NotSoNinja/Looma-Motherboard-R2/README.md

Looma-Motherboard-R2
====================

Revision 2+ of Looma's Motherboard
