NotSoNinja/Looma-Motherboard-R2/MotherBoard Design Review Presentation.pptx

## Looma 2 Motherboard Design Review

## Motherboard Components

Previous Design:
- 5V Buck Circuit
- Audio Amplifier
- USB Hub
- Ethernet
Re-designed:
- Surge Stopper
- 19.5V Boost Circuit
- Added Fan Control

## Slide 3

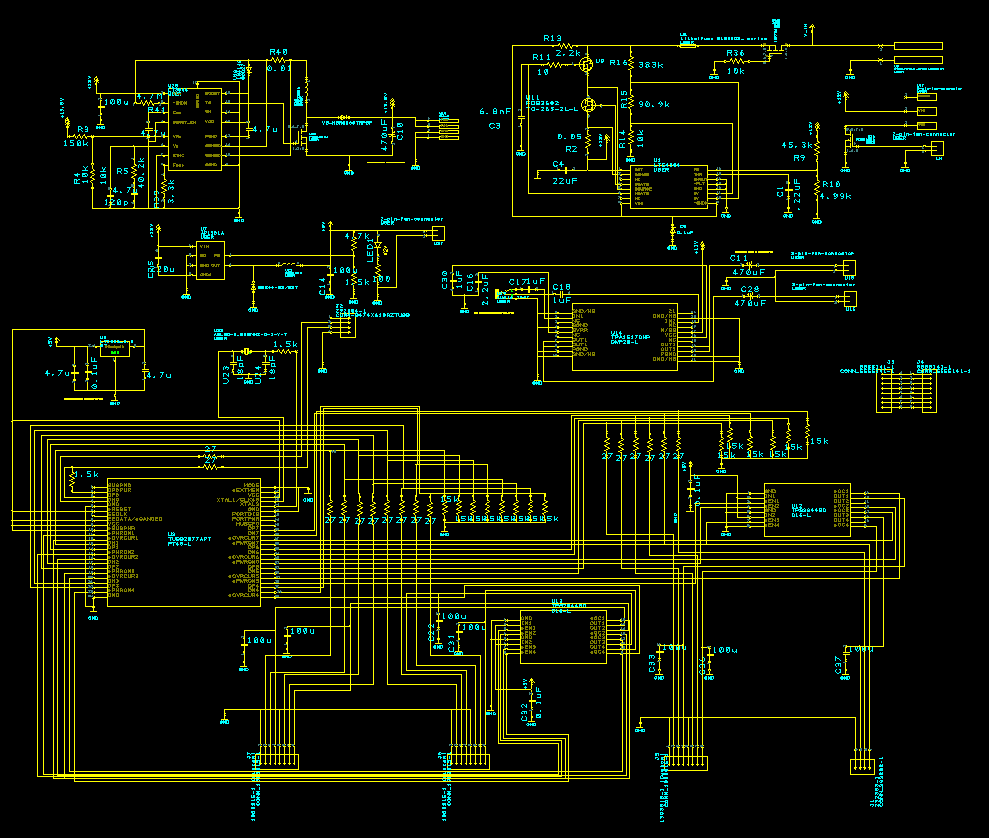
[picture p1: figure]

## Surge Protector

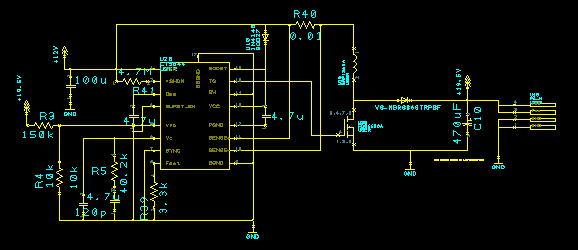
[picture p2: figure]

## Boost Circuit Protector

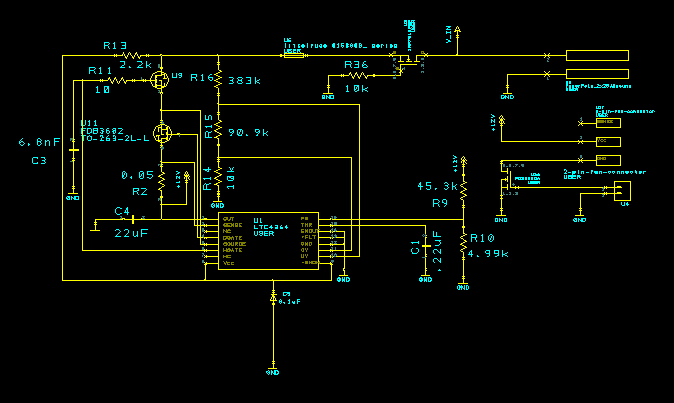
[picture p3: figure]

## Slide 6

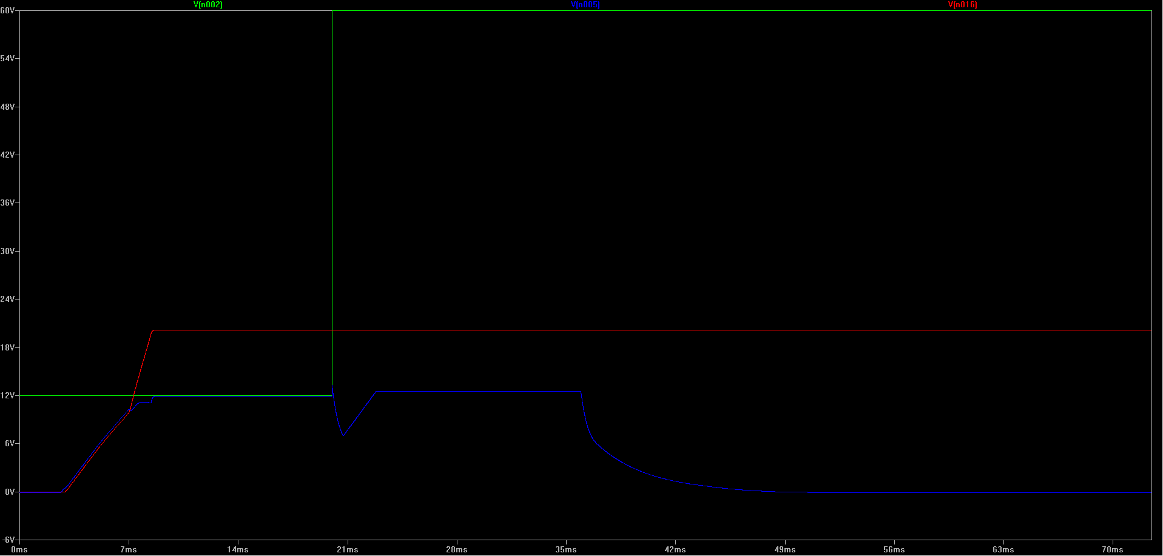
[picture p4: figure]

Boost Circuit + Surge Protector without Load

Boost Circuit Output = 19.68 V

Surge Protector Output = Boost Circuit Input

Surge Protector Input

Notes: No load

## Slide 7

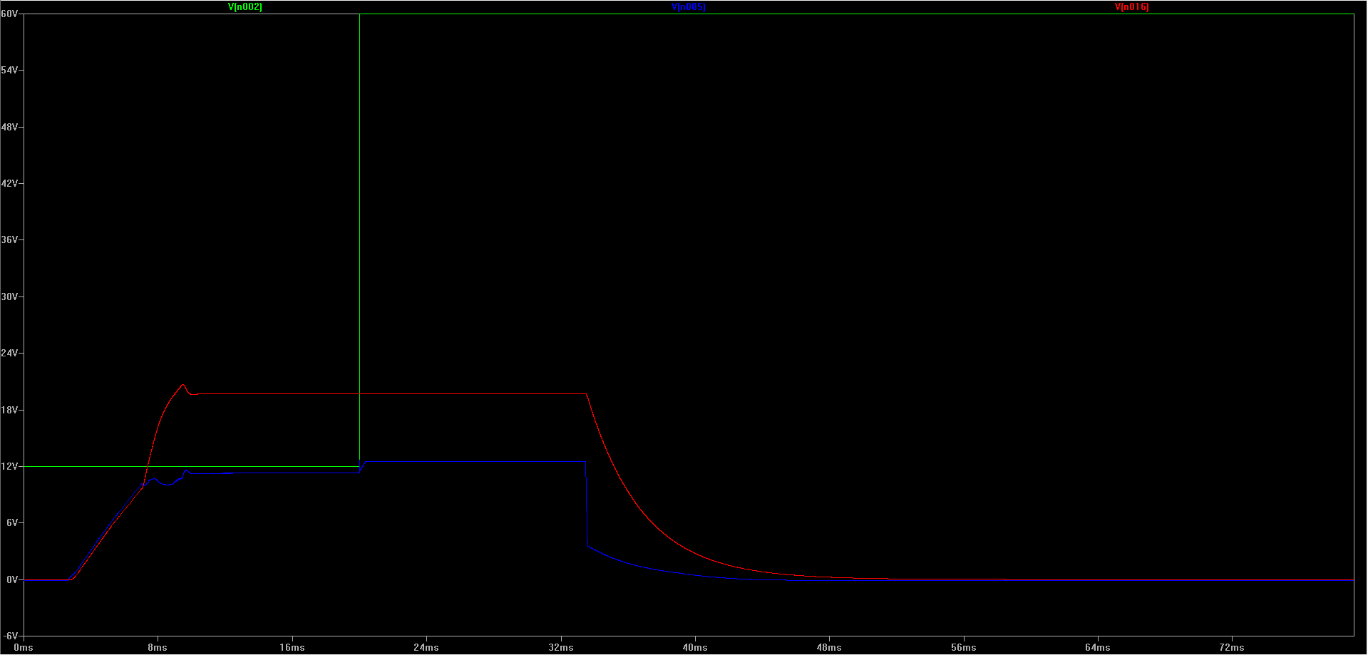
[picture p5: figure]

Boost Circuit + Surge Protector with Load

Surge Protector Output = Boost Circuit Input

Surge Protector Input

Boost Circuit Output = 19.68 V

Notes: Load

## Slide 8

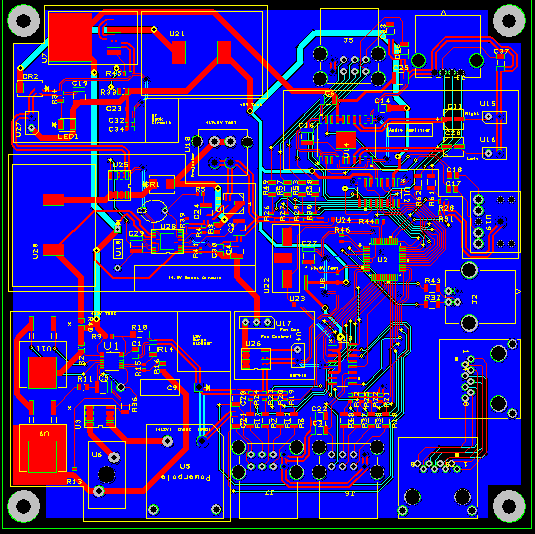
[picture p6: figure]
