NotSoNinja/Looma-Motherboard-R2/Looma 2 Components Flow Chart.jpeg

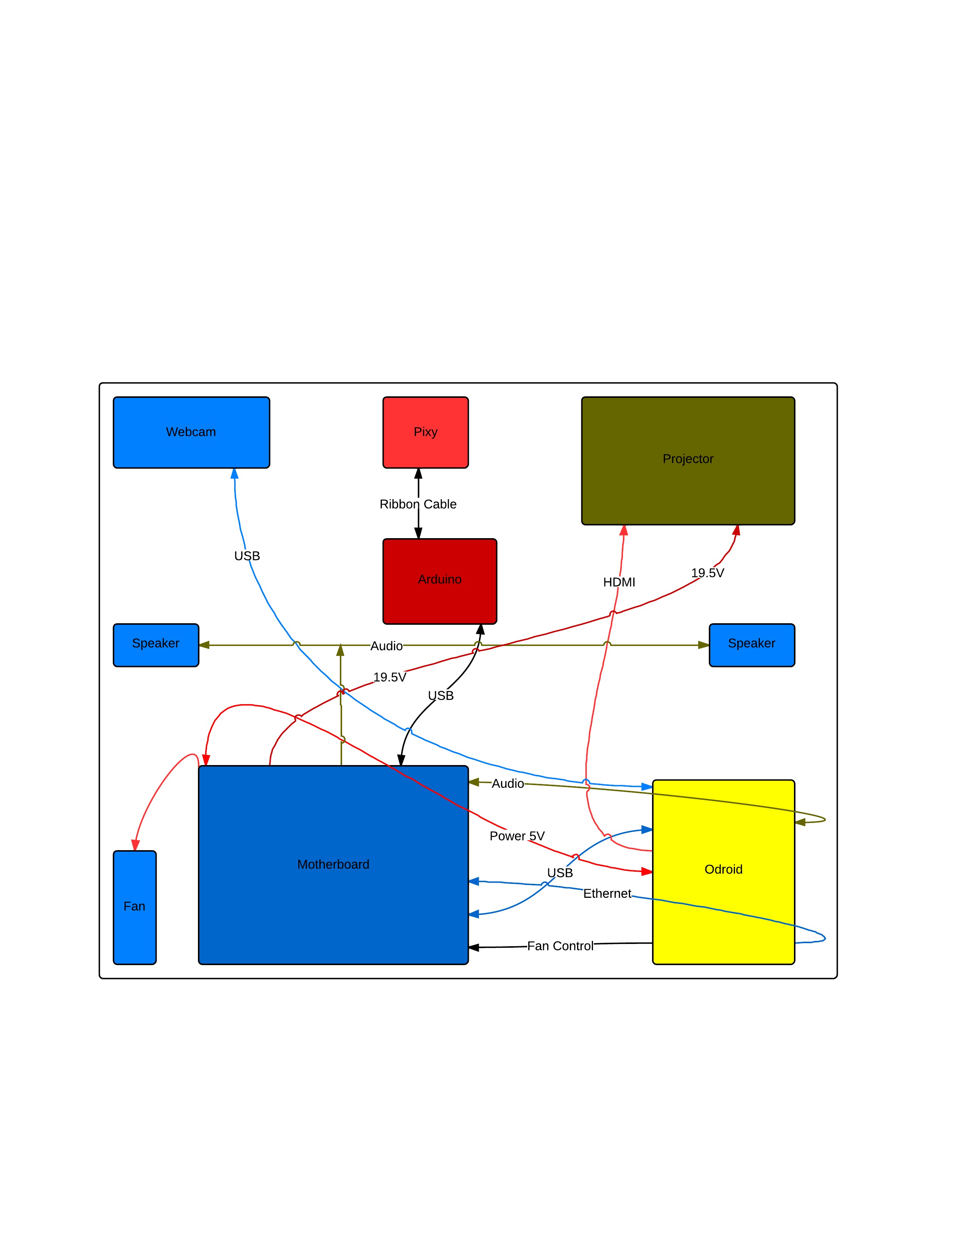
Looma 2 Components Flow Chart.jpeg
