NotSoNinja/Looma-Motherboard-R2/Mother Board R2.4 - Schematic - Schematic.pdf

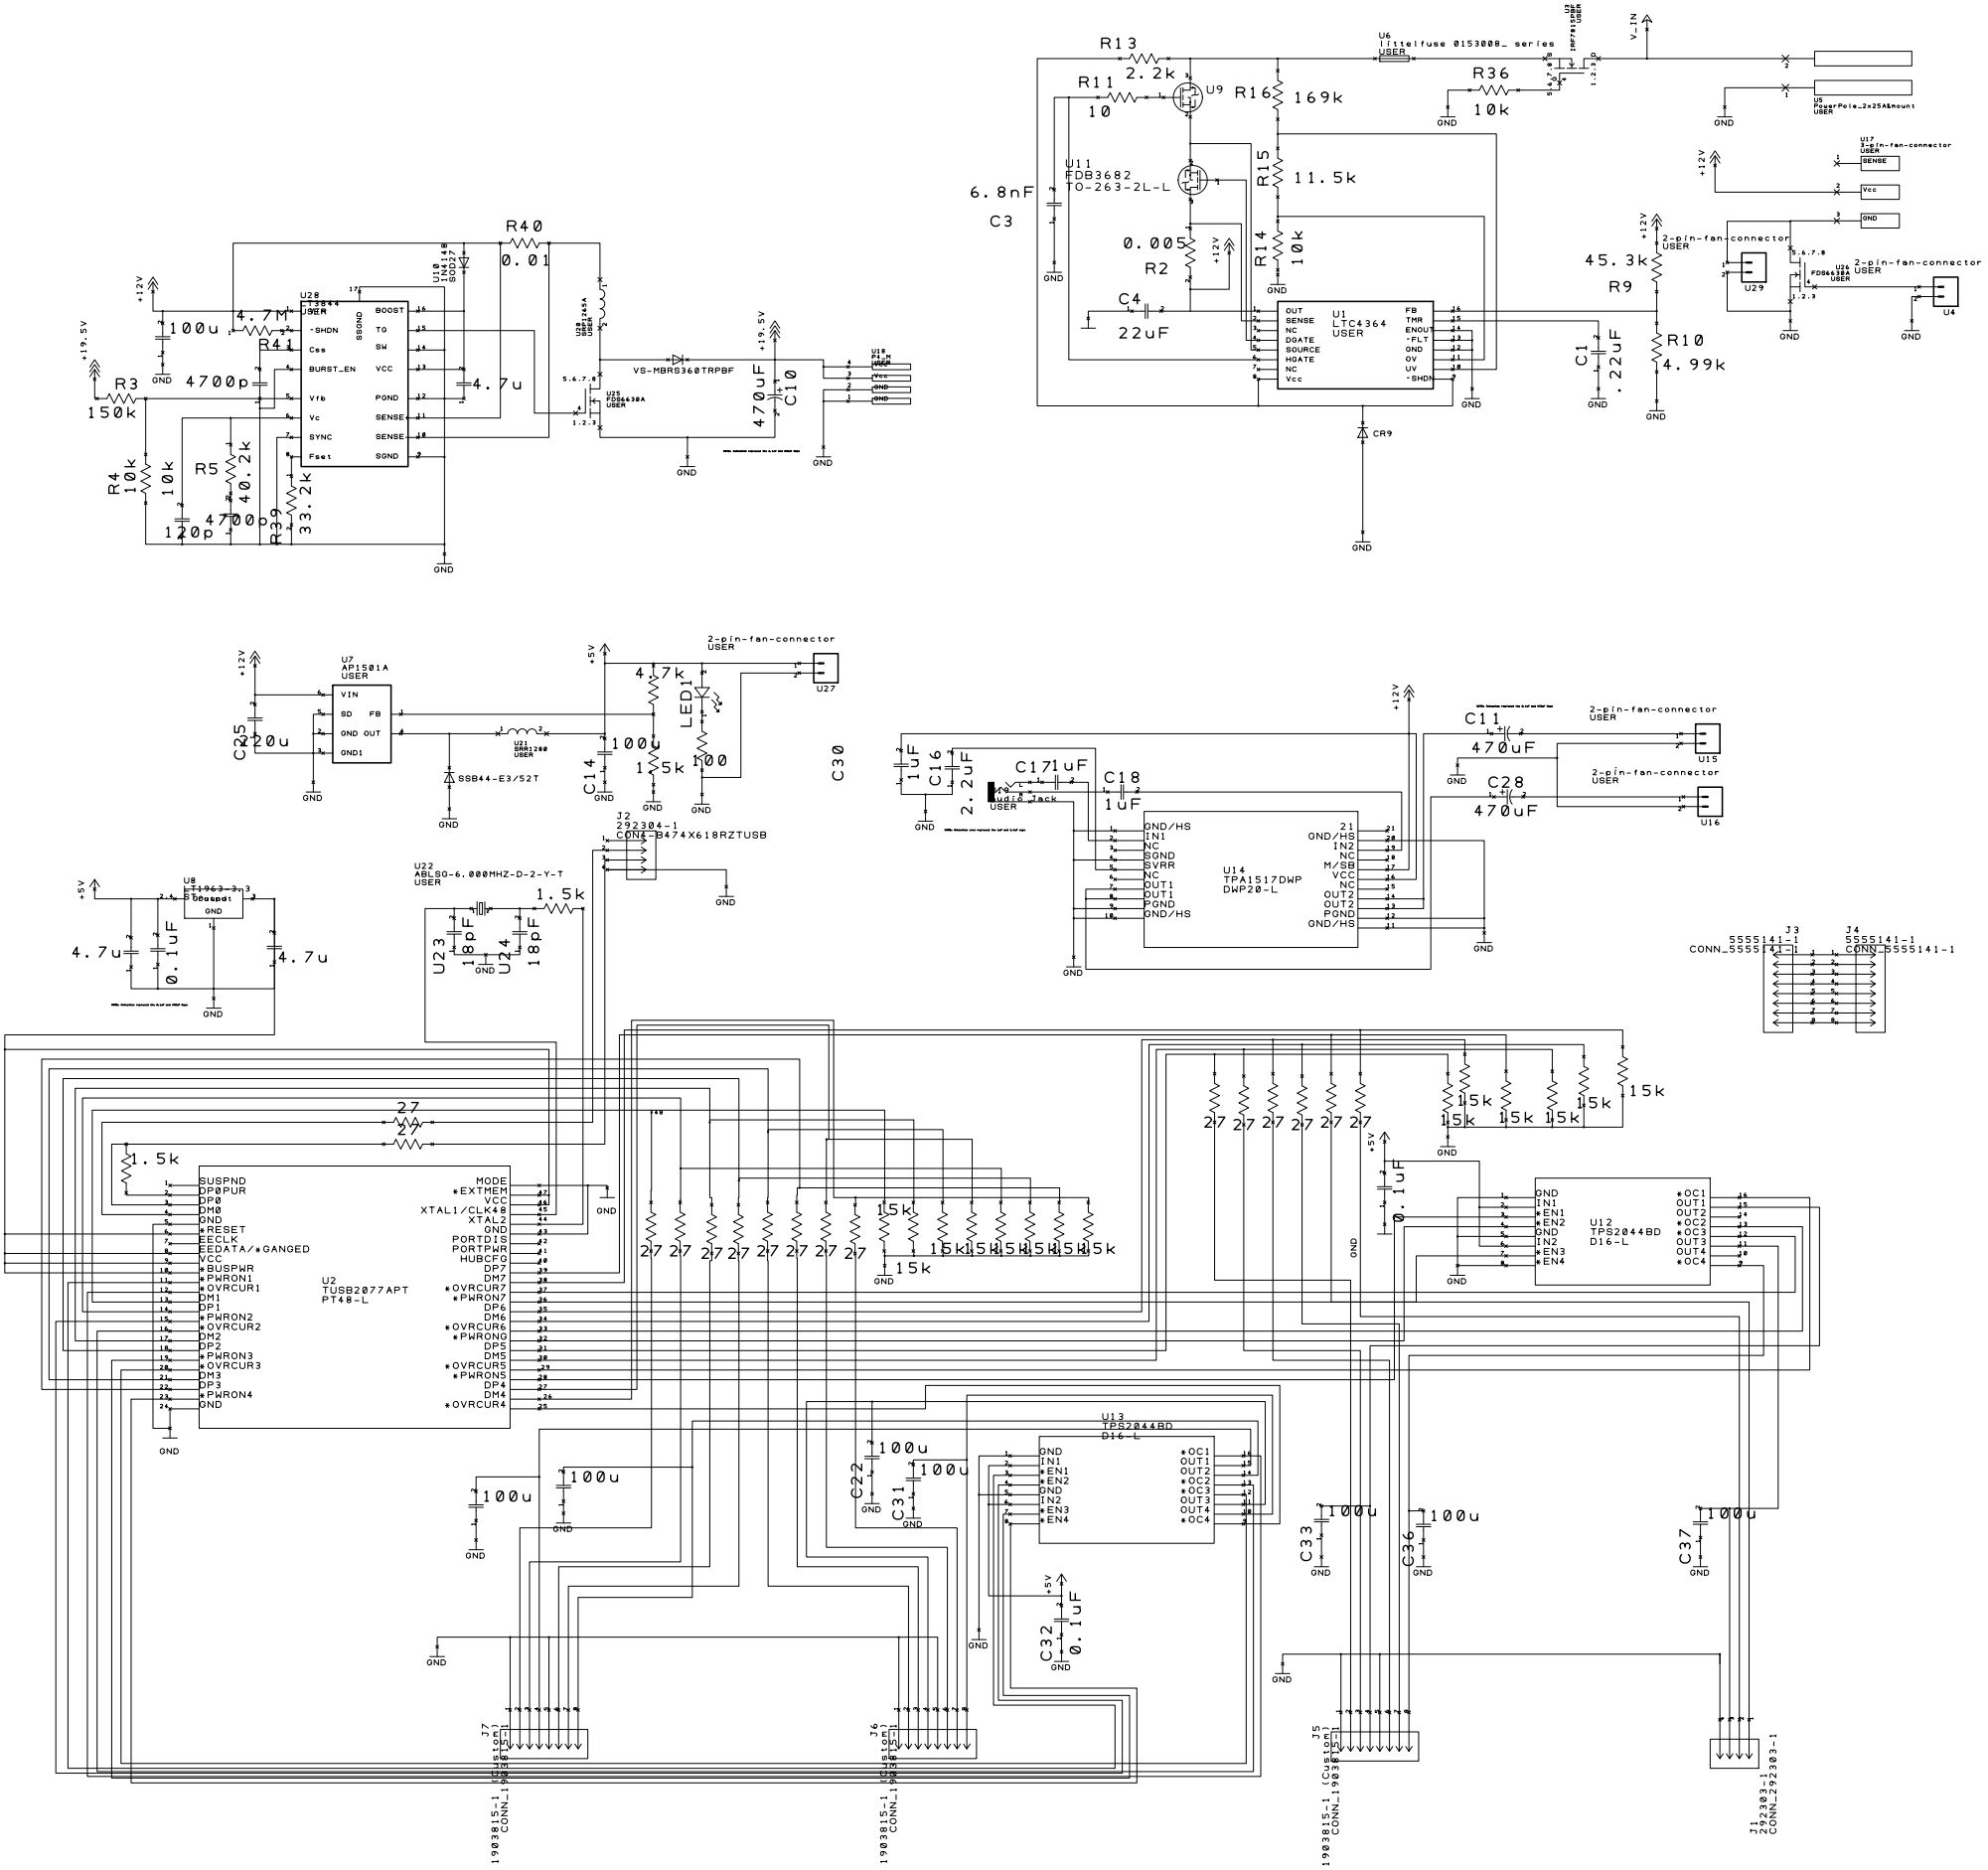
[picture p10: page 1]
