NotSoNinja/Looma-Motherboard-R2/Looma Systems Integration.asc

C1: cap; .22µ
C2: cap; 6.8nf
C3: cap; 22µ
C5: cap; 2.2µ
C6: cap; 470µ
C7: cap; 4700p
C8: cap; 120p
C9: cap; 4700p
C10: cap; 100µ
D1: zener; 1N5373B
D2: diode; 1N4148
D3: schottky; MBRS360
L1: ind; 15µ
M1: nmos; FDB33N25
M2: nmos; FDB3682
M3: nmos; FDS6630A
M4: nmos; Si7370DP
M5: nmos; FDB33N25
R1: res; 169k
R2: res; 11.5k
R3: res; 10k
R4: res; 2.2k
R5: res; 10
R6: res; .005
R7: res; 45k
R8: res; 4.99k
R9: res; 60
R10: res; 4.7m
R11: res; .01
R12: res; 150k
R13: res; 33.2k
R14: res; 10k
R15: res; 40k
R17: res; 6
U1: LTC4364-2
U2: LT3844
V1: voltage; 12
V2: voltage; 5
V3: voltage; PULSE(0 12 .015)
Named nets: 0
.tran 5
