NotSoNinja/Looma-Motherboard-R2/(list of files, drawings)

Other design files:
Mother Board R2.4.pcb
Mother Board R2.41.pcb
R2.5/Looma_2.5_BoostOnly.pcb
R2.5/Looma_2.5_Data_Module.pcb
R2.5/Looma_2.5_Power_Module_A.pcb
R2.5/~Looma_2.5_BoostOnly.pcb
R2.5/~Looma_2.5_Power_Module_A.pcb
