NotSoNinja/Looma-Motherboard-R2/R2 Source/Mother Board R2 - COPY.brd

## EAGLE design R2 Source/Mother Board R2 - COPY.brd (2014-07-31, an earlier design)

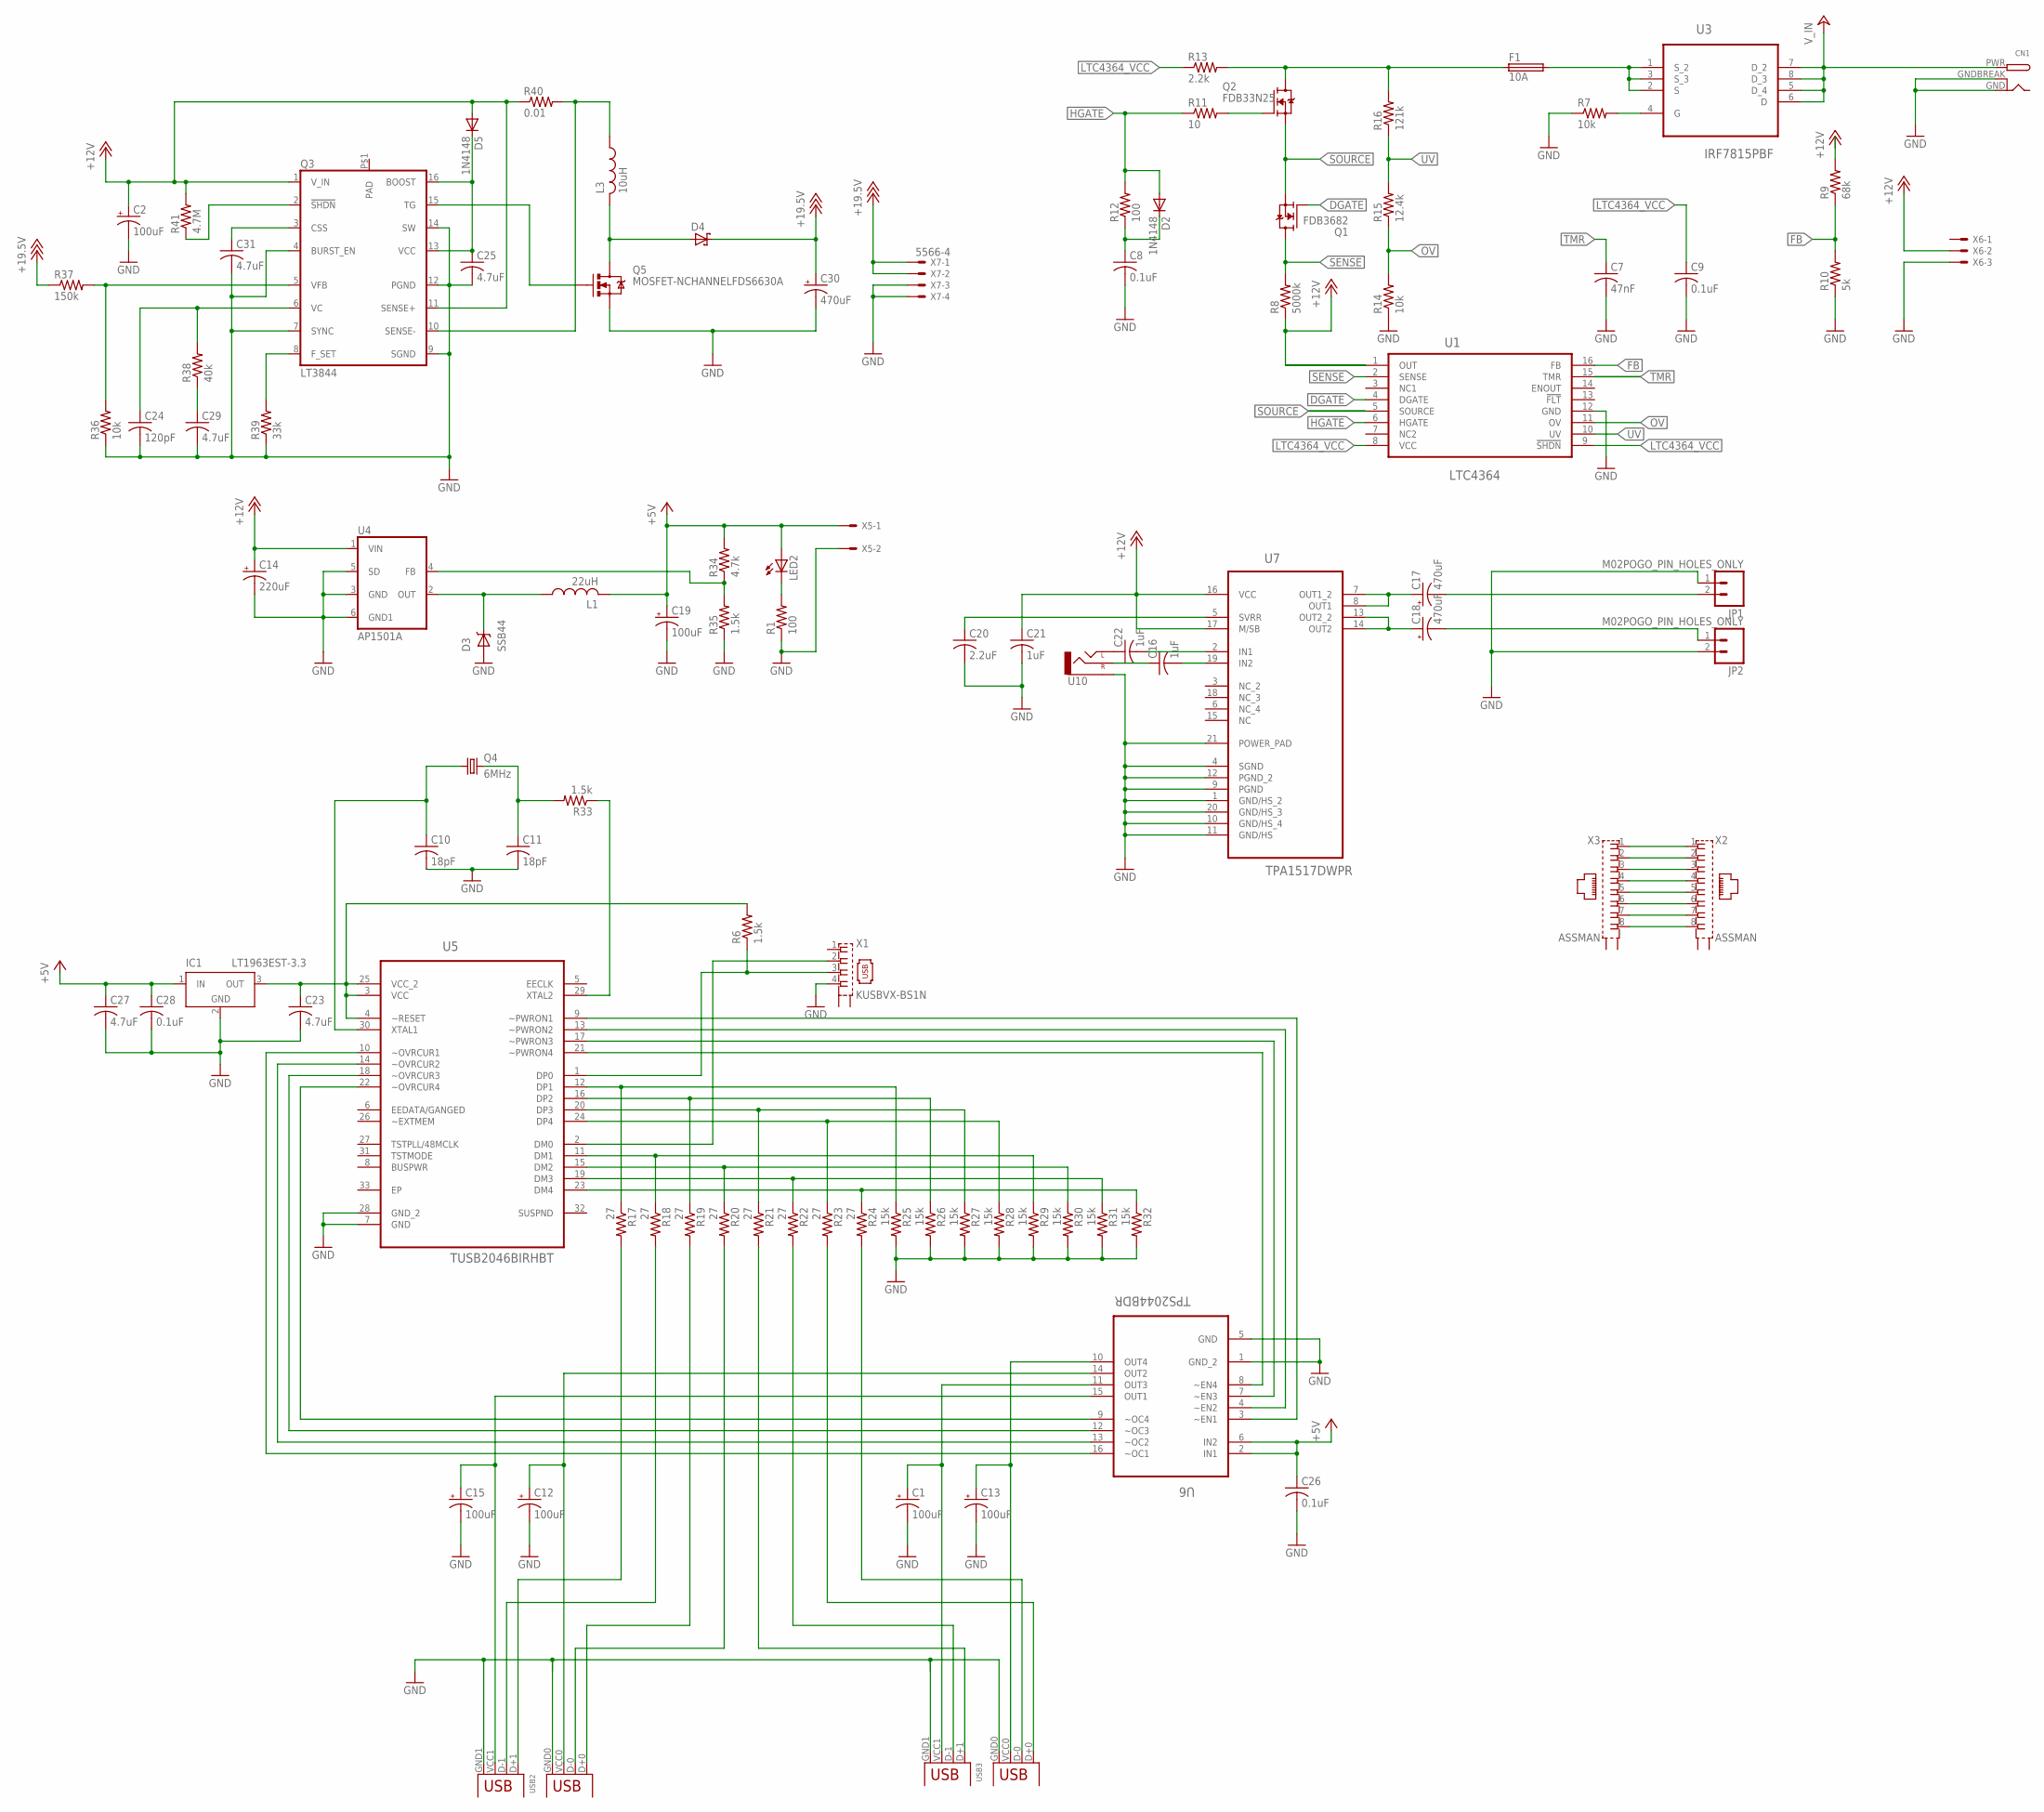
[picture p11: schematic Mother Board R2 - COPY.sch]

Parts:
C1, C2, C12, C13, C15, C19: 100uF; PANASONIC_D; MPN 107SML016M
C7: 47nF; C1206; MPN 12061C473KAZ1A
C8, C9, C26, C28: 0.1uF; C0603; MPN 0603YC104MAT2A
C10, C11: 18pF; C0603; MPN 06035A180JAT2A
C14: 220uF; PANASONIC_D; MPN 16SVPF270M
C16, C21, C22: 1uF; C1206; MPN C1206C105K3RACTU
C17, C18, C30: 470uF; PANASONIC_D; MPN 107SML016M
C20: 2.2uF; C1206; MPN 1206YC225KAT2A
C23, C25, C27, C29, C31: 4.7uF; C0805; MPN CGA4J3X7R1C475K125AB
C24: 120pF; C0805; MPN CGA4J3X7R1C475K125AB
CN1: DCBARRELPTH; DCJACK_2MM_PTH
D2, D5: 1N4148; SOD323; MPN 1N4148WS-7-F
D3: SSB44; SMB; MPN SSB44-E3/52T
D4: SCHOTTKY-DIODESMC; DIODE_SMC; MPN B550C-13-F
F1: 10A; MINIFUSE; MPN 01530007Z
IC1: LT1963EST-3.3; SOT223
JP1, JP2: M02POGO_PIN_HOLES_ONLY; 1X02_PP_HOLES_ONLY
L1: 22uH; BOURNSIND; MPN SRR1280-220M
L3: 10uH; BOURNSIND; MPN SRR1280-220M
LED2: LEDCHIPLED_1206; CHIPLED_1206; MPN KP-3216CGCK
Q1: FDB3682; TO263; MPN STB35NF10T4
Q2: FDB33N25; TO263; MPN FDB33N25TM
Q3: LT3844; TSSOP16-TPAD
Q4: 6MHz; HC49UP; MPN ABLSG-6.000MHZ-D-2-Y-T
Q5: MOSFET-NCHANNELFDS6630A; SO08
R1, R12: 100; R1206; MPN MCHP06W2F1000T5E
R6, R33: 1.5k; R1206; MPN MCHP06W2F1501T5E
R7, R14, R36: 10k; R1206; MPN MCHP06W2F1002T5E
R8: 5000k; R1206; MPN CRCW12065M10JNEA
R9: 68k; R1206; MPN CRCW120668K0FKEA
R10: 5k; R1206; MPN ERJ-8ENF5101V
R11: 10; R1206; MPN CRM1206-FX-10R0ELF
R13: 2.2k; R1206; MPN CRCW12062K20FKTA
R15: 12.4k; R1206; MPN CRCW120612K4FKEA
R16: 121k; R1206; MPN CRCW1206121KFKEA
R17, R18, R19, R20, R21, R22, R23, R24: 27; R1206; MPN MCHP06W2F270JT5E
R25, R26, R27, R28, R29, R30, R31, R32: 15k; R1206; MPN MCHP06W2F1502T5E
R34: 4.7k; R1206; MPN MC0125W12061120K
R35: 1.5k; R1206; MPN MC0125W12061120K
R37: 150k; R1206; MPN MCHP06W2F1002T5E
R38: 40k; R1206; MPN MCHP06W2F1002T5E
R39: 33k; R1206; MPN MCHP06W2F1002T5E
R40: 0.01; R1206; MPN MCHP06W2F1002T5E
R41: 4.7M; R1206; MPN MCHP06W2F1002T5E
U1: LTC4364; MSOP-16; MPN LTC4364IS-1#PBF
U3: IRF7815PBF; SOIC127P600X175-8N
U4: AP1501A; TO263-5
U5: TUSB2046BIRHBT; QFN50P500X500X100-33N
U6: TPS2044BDR; SOIC127P600X175-16N
U7: TPA1517DWPR; SOIC127P1030X265-21N; MPN TPA1517DWPR
U10: AUDIO-JACKPTH; AUDIO-JACK; MPN SPC21348
USB2, USB3: DUALUSB; USB-A-DS; MPN 5787617-1
X1: KUSBVX-BS1N; MPN MC32597
X2, X3: ASSMAN
X5: KK-156-2
X6: KK-156-3
X7: 5566-4; MPN 39-29-9042

Connections:
+5V: C19.+, C26.1, C27.1, C28.1, IC1.1 (IN), L1.P$2 (2), LED2.A, R34.2, U6.2 (IN1), U6.6 (IN2), X5.1
+12V: C2.+, C14.+, C21.1, D5.A, Q3.1 (V_IN), Q3.11 (SENSE+), R8.1, R9.2, R40.1, R41.2, U1.1 (OUT), U4.1 (VIN), U7.16 (VCC), U7.17 (M/SB), X6.2
+18V: C30.+, D4.C (A), R37.1, X7.1, X7.2
DGATE: Q1.1 (G), U1.4 (DGATE)
FB: R9.1, R10.2, U1.16 (FB)
GND: C1.-, C2.-, C7.2, C8.2, C9.2, C10.2, C11.2, C12.-, C13.-, C14.-, C15.-, C19.-, C20.2, C21.2, C23.2, C24.2, C25.2, C26.2, C27.2, C28.2, C29.2, C30.-, C31.2, CN1.GND, CN1.GNDBREAK, D3.A, IC1.2 (GND), IC1.4 (GND), JP1.1, JP2.2, Q3.4 (BURST_EN), Q3.7 (SYNC), Q3.9 (SGND), Q3.12 (PGND), Q3.14 (SW), Q5.1 (S), Q5.2 (S), Q5.3 (S), R1.1, R7.1, R10.1, R14.1, R25.2, R26.2, R27.2, R28.2, R29.2, R30.2, R31.2, R32.2, R35.1, R36.1, R39.1, U1.12 (GND), U4.3 (GND), U4.5 (SD), U4.6 (GND1), U5.7 (GND), U5.28 (GND_2), U6.1 (GND_2), U6.5 (GND), U7.1 (GND/HS_2), U7.4 (SGND), U7.9 (PGND), U7.10 (GND/HS_4), U7.11 (GND/HS), U7.12 (PGND_2), U7.20 (GND/HS_3), U7.21 (POWER_PAD), U10.SLEEVE, USB2.GND0 (GND), USB2.GND1, USB3.GND0 (GND), USB3.GND1, X1.4, X5.2, X6.3, X7.3, X7.4
HGATE: D2.A, R11.1, R12.2, U1.6 (HGATE)
LTC4364_VCC: C9.1, R13.1, U1.8 (VCC), U1.9 (!SHDN)
unnamed: F1.P$1 (1), Q2.3 (D), R13.2, R16.2
unnamed: D3.C, L1.P$1 (1), U4.2 (OUT)
unnamed: LED2.C, R1.2
unnamed: U5.2 (DM0), X1.2
unnamed: R6.1, U5.1 (DP0), X1.3
unnamed: C23.1, IC1.3 (OUT), R6.2, U5.3 (VCC), U5.4 (~RESET), U5.25 (VCC_2)
unnamed: R17.1, R25.1, U5.12 (DP1)
unnamed: Q2.1 (G), R11.2
unnamed: R18.1, R29.1, U5.11 (DM1)
unnamed: C8.1, D2.C, R12.1
unnamed: R19.1, R26.1, U5.16 (DP2)
unnamed: F1.P$2 (2), U3.1 (S_2), U3.2 (S), U3.3 (S_3)
unnamed: R20.1, R30.1, U5.15 (DM2)
unnamed: R7.2, U3.4 (G)
unnamed: R21.1, R27.1, U5.20 (DP3)
unnamed: R22.1, R31.1, U5.19 (DM3)
unnamed: R23.1, R28.1, U5.24 (DP4)
unnamed: R24.1, R32.1, U5.23 (DM4)
unnamed: C10.1, Q4.1, U5.30 (XTAL1)
unnamed: C11.1, Q4.2, R33.2
unnamed: R33.1, U5.29 (XTAL2)
unnamed: U5.21 (~PWRON4), U6.8 (~EN4)
unnamed: U5.17 (~PWRON3), U6.7 (~EN3)
unnamed: U5.13 (~PWRON2), U6.4 (~EN2)
unnamed: U5.9 (~PWRON1), U6.3 (~EN1)
unnamed: U5.22 (~OVRCUR4), U6.9 (~OC4)
unnamed: U5.18 (~OVRCUR3), U6.12 (~OC3)
unnamed: U5.14 (~OVRCUR2), U6.13 (~OC2)
unnamed: U5.10 (~OVRCUR1), U6.16 (~OC1)
unnamed: C15.+, U6.15 (OUT1), USB2.VCC1 (VBUS1)
unnamed: C12.+, U6.14 (OUT2), USB2.VCC0 (VBUS)
unnamed: C1.+, U6.11 (OUT3), USB3.VCC1 (VBUS1)
unnamed: C13.+, U6.10 (OUT4), USB3.VCC0 (VBUS)
unnamed: R17.2, USB2.D+1
unnamed: R18.2, USB2.D-1
unnamed: R19.2, USB2.D+0 (D+)
unnamed: R20.2, USB2.D-0 (D-)
unnamed: R21.2, USB3.D+1
unnamed: R22.2, USB3.D-1
unnamed: R23.2, USB3.D+0 (D+)
unnamed: R24.2, USB3.D-0 (D-)
unnamed: C20.1, U7.5 (SVRR)
unnamed: C22.1, U10.TIP (LEFT)
unnamed: C22.2, U7.2 (IN1)
unnamed: C16.1, U10.RING (RIGHT)
unnamed: C16.2, U7.19 (IN2)
unnamed: C17.+, U7.7 (OUT1_2), U7.8 (OUT1)
unnamed: C18.+, U7.13 (OUT2_2), U7.14 (OUT2)
unnamed: C18.-, JP2.1
unnamed: C17.-, JP1.2
unnamed: X2.1, X3.1
unnamed: X2.2, X3.2
unnamed: X2.3, X3.3
unnamed: X2.4, X3.4
unnamed: X2.5, X3.5
unnamed: X2.6, X3.6
unnamed: X2.7, X3.7
unnamed: X2.8, X3.8
unnamed: R34.1, R35.2, U4.4 (FB)
unnamed: Q3.2 (!SHDN), R41.1
unnamed: C31.1, Q3.3 (CSS)
unnamed: C24.1, Q3.6 (VC), R38.2
unnamed: C29.1, R38.1
unnamed: Q3.5 (VFB), R36.2, R37.2
unnamed: Q3.8 (F_SET), R39.2
unnamed: C25.1, D5.C, Q3.13 (VCC), Q3.16 (BOOST)
unnamed: L3.P$1 (1), Q3.10 (SENSE-), R40.2
unnamed: Q3.15 (TG), Q5.4 (G)
unnamed: D4.A (C), L3.P$2 (2), Q5.5 (D), Q5.6 (D), Q5.7 (D), Q5.8 (D)
OV: R14.2, R15.1, U1.11 (OV)
SENSE: Q1.3 (D), R8.2, U1.2 (SENSE)
SOURCE: Q1.2 (S), Q2.2 (S), U1.5 (SOURCE)
TMR: C7.1, U1.15 (TMR)
UV: R15.2, R16.1, U1.10 (UV)
V_IN: CN1.PWR, U3.5 (D_4), U3.6 (D), U3.7 (D_2), U3.8 (D_3)

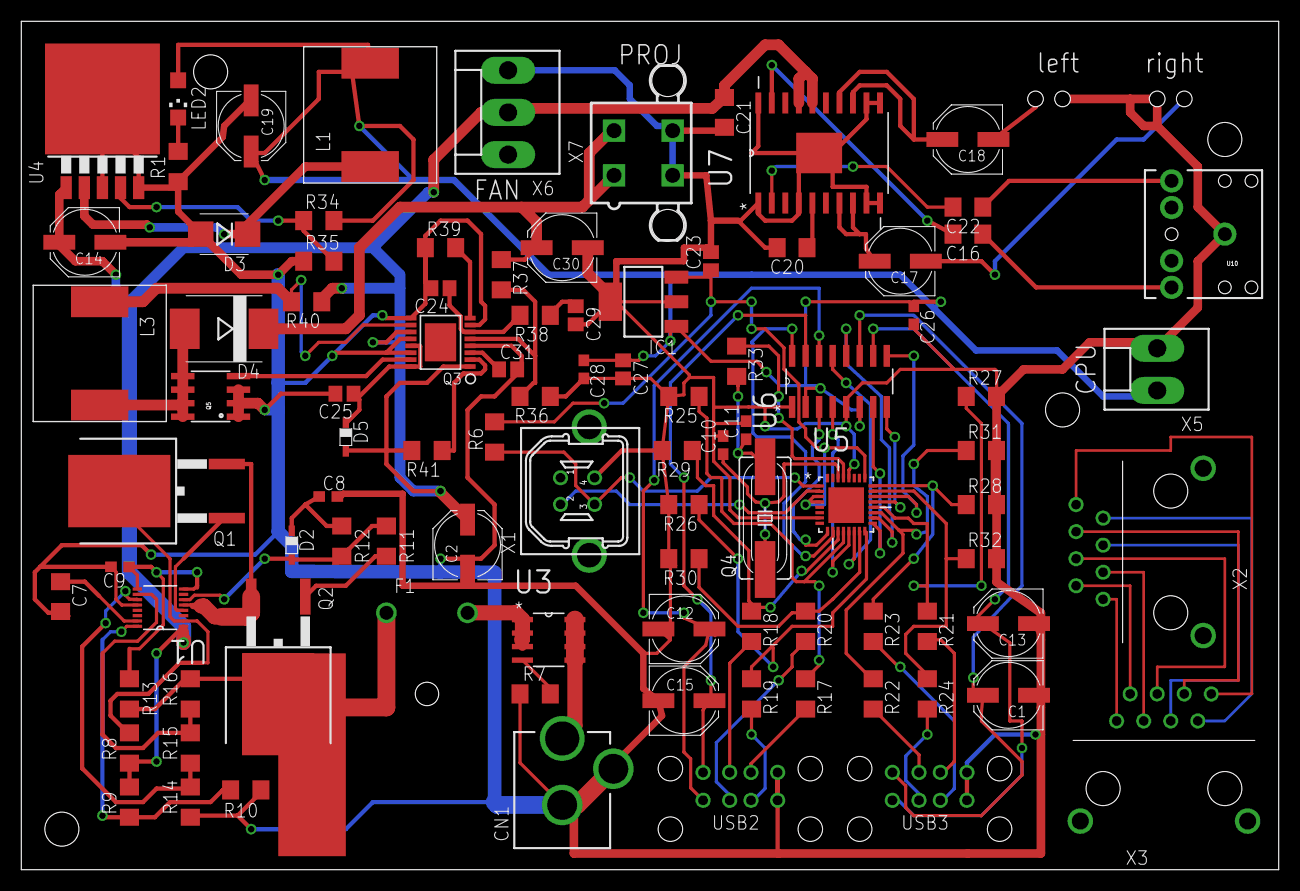
[picture p12: board Mother Board R2 - COPY.brd from above]

Board: 2 copper layers, 118.1 x 79.7 mm, 96 parts (0 on the bottom side), 83 nets.
