NotSoNinja/Looma-Motherboard-R2/(commit log)

2014-07-31 CONTENT PATCH!
    Added WIP content for board
    [BOM for Wolff.xlsx, Mother Board R2.4 - Schematic.sch, Mother Board R2.4.pcb, Mother Board R2.41.pcb]
2014-07-31 Added Original Source
    Colorado School of Mines board and schematic that continuing work is
    based on.
    [Mother Board R2 - COPY.brd, Mother Board R2 - COPY.sch, Mother Board R2 Parts List.xlsx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]
2014-07-31 Added Design Review Powerpoint
    Because reasons.
2014-08-07 Added folder for revision 2.5
    [Looma_2.5_BoostOnly.pcb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]
